ZSWatch/ZSWatch/website/blog/2026-05-31-first-real-prototype/watch-usb-c-connected-debugger-breakout.jpg

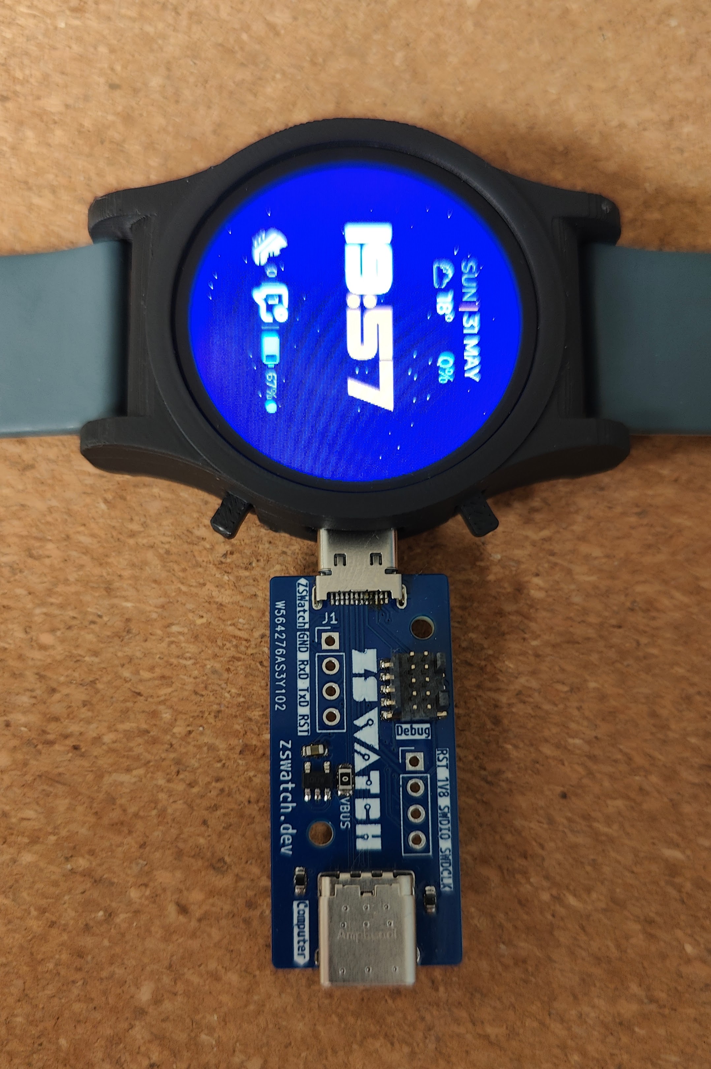
website/blog/2026-05-31-first-real-prototype/watch-usb-c-connected-debugger-breakout.jpg
