ZSWatch/ZSWatch/website/blog/2026-05-31-first-real-prototype/assembled-first-protototype-watch.jpg

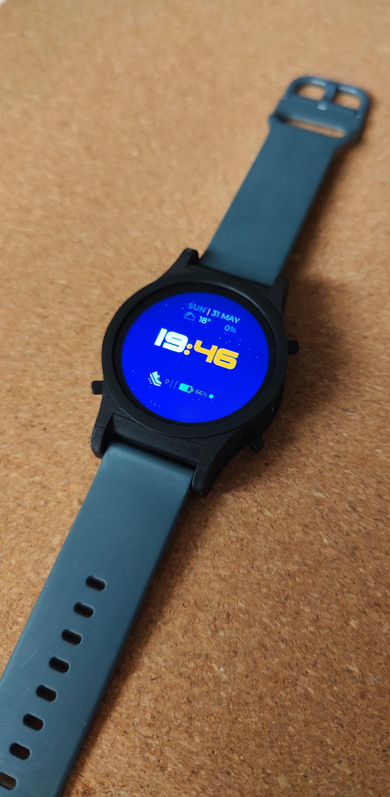
website/blog/2026-05-31-first-real-prototype/assembled-first-protototype-watch.jpg
