ZSWatch/ZSWatch/website/blog/2026-05-31-first-real-prototype/app_pick_local_bg_crop.jpg

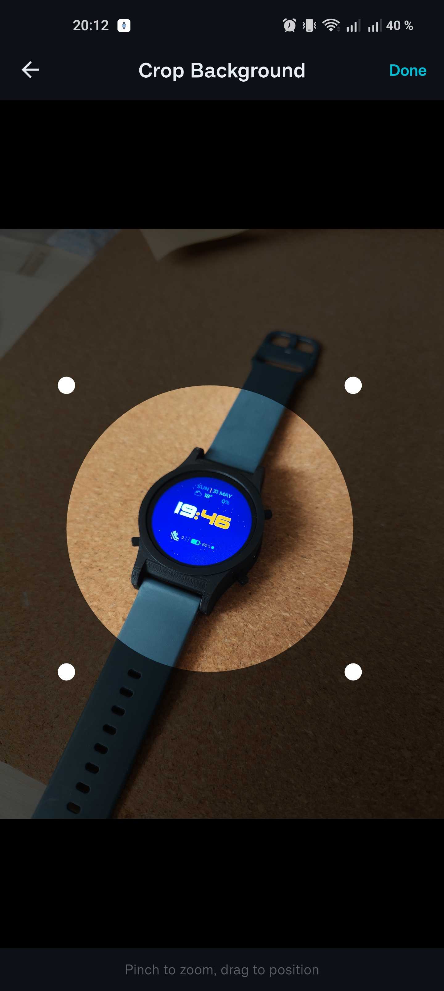
website/blog/2026-05-31-first-real-prototype/app_pick_local_bg_crop.jpg
