ZSWatch/ZSWatch/website/blog/2026-05-31-first-real-prototype/app_pre_made_watch_bgs.jpg

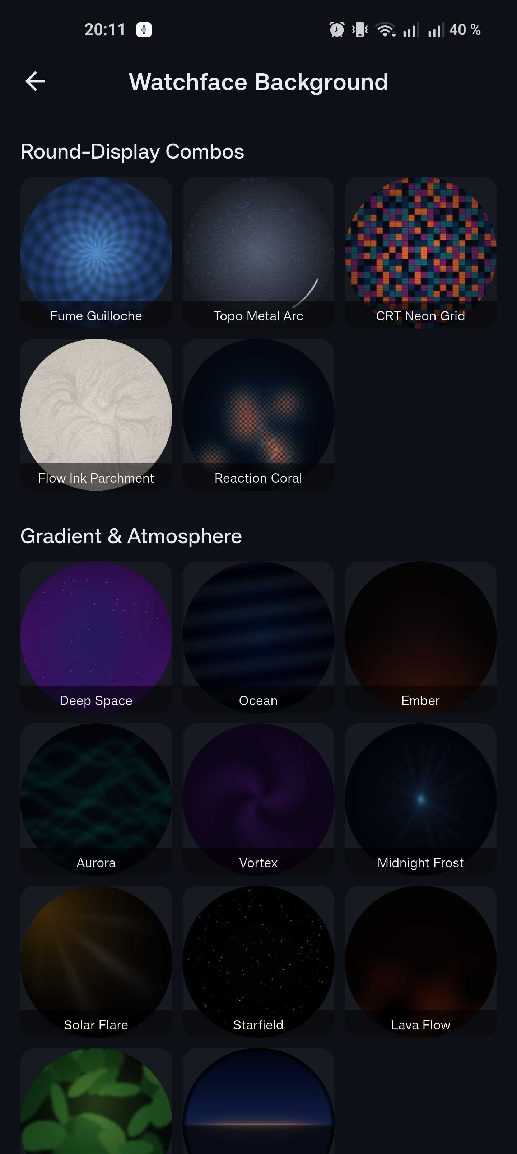
website/blog/2026-05-31-first-real-prototype/app_pre_made_watch_bgs.jpg
