ZSWatch/ZSWatch/website/blog/2026-05-31-first-real-prototype/bare-pcb-watch-and-hr-extention.jpg

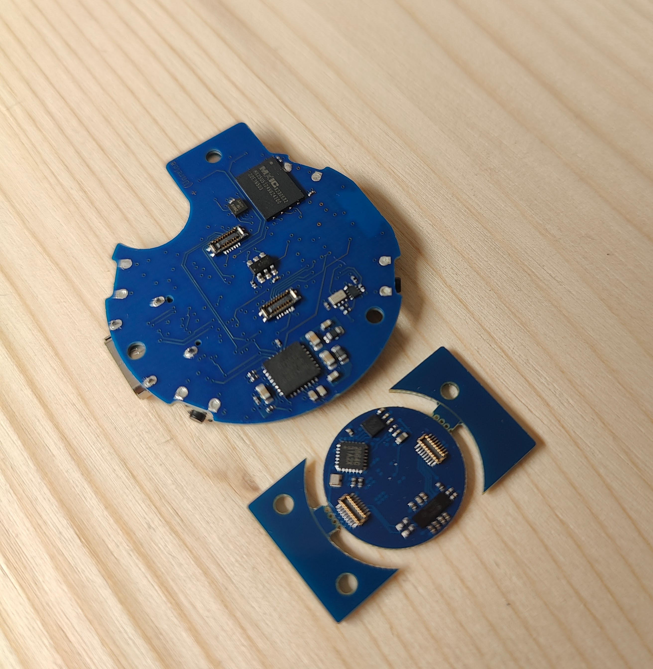
website/blog/2026-05-31-first-real-prototype/bare-pcb-watch-and-hr-extention.jpg
