ZSWatch/ZSWatch/website/blog/2026-05-31-first-real-prototype/bare-pcb-with-hr-mounted-bottom-view.jpg

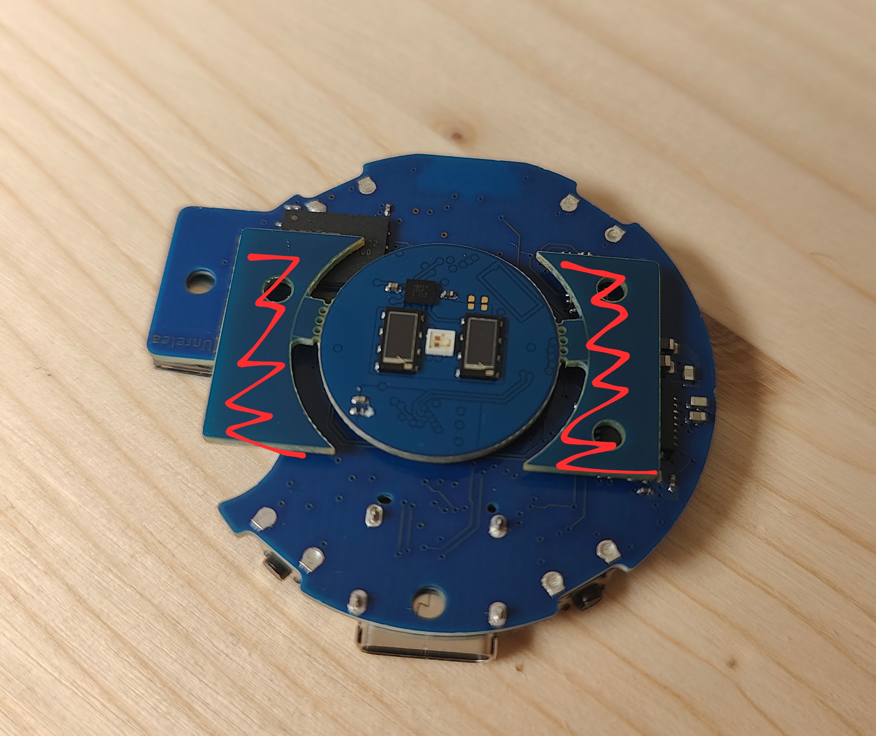
website/blog/2026-05-31-first-real-prototype/bare-pcb-with-hr-mounted-bottom-view.jpg
