ZSWatch/ZSWatch/website/blog/2026-10-28-zswatch-1-0/chat_answer.png

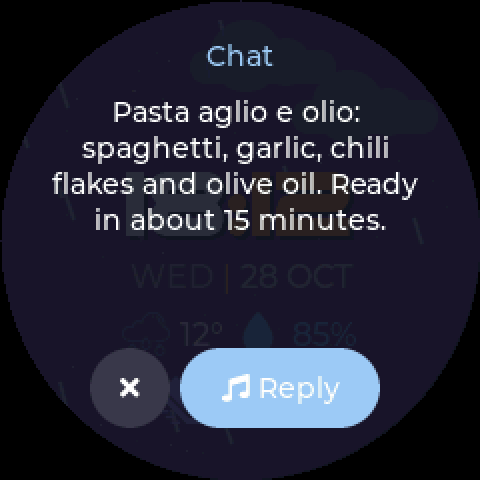
website/blog/2026-10-28-zswatch-1-0/chat_answer.png
