ZSWatch/ZSWatch/app/src/drivers/zsw_vibration_motor.h

/*
 * This file is part of ZSWatch project <https://github.com/zswatch/>.
 * Copyright (c) 2025 ZSWatch Project.
 *
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
 * You should have received a copy of the GNU General Public License
 * along with this program. If not, see <http://www.gnu.org/licenses/>.
 */

#pragma once

#include <stdbool.h>

typedef enum zsw_vibration_pattern {
    ZSW_VIBRATION_PATTERN_CLICK,
    ZSW_VIBRATION_PATTERN_NOTIFICATION,
    ZSW_VIBRATION_PATTERN_ALARM,
    ZSW_VIBRATION_PATTERN_QUICK_REC_START,   /* Short-Long: recording started */
    ZSW_VIBRATION_PATTERN_QUICK_REC_STOP,    /* Short-Short: recording stopped */
    ZSW_VIBRATION_PATTERN_QUICK_REC_ERROR,   /* Long-Long: recording error */
    ZSW_VIBRATION_PATTERN_FIND,              /* Triple buzz: find device */
} zsw_vibration_pattern_t;

/*
* @brief Run a vibration pattern
*
* @details Run a vibration pattern, the pattern will run asynchronously and
* any try to run a pattern while another is running will result in -EBUSY.
*
* @param pattern The pattern to run
* @return 0 on success, negative error code on failure
*/
int zsw_vibration_run_pattern(zsw_vibration_pattern_t pattern);

/*
 * @brief Run a vibration pattern in loop
 *
 * @details Run a vibration pattern in a loop until @ref zsw_vibration_stop is called,
 * the pattern will run asynchronously and any try to run a pattern while another
 * is running will result in -EBUSY.
 *
 * @param pattern The pattern to run
 * @return 0 on success, negative error code on failure
 */
int zsw_vibration_run_pattern_loop(zsw_vibration_pattern_t pattern);

/*
 * @brief Stop any ongoing vibration pattern
 *
 * @details This can be used to stop an ongoing pattern, for example when
 * a timer alarm is dismissed.
*/
void zsw_vibration_stop(void);

/*
* @brief Enable or disable the vibration motor
*
* @details Used to globally disable the vibration motor, for example when the watch
* is in DND mode or when battery is low.
*
* @param enable true to enable, false to disable
*/
int zsw_vibration_set_enabled(bool enable);

/* Stop only a currently running Find pattern; leave alarms/notifications alone. */
bool zsw_vibration_stop_find(void);
