ZSWatch/ZSWatch/app/src/zsw_clock.c

/*
 * This file is part of ZSWatch project <https://github.com/zswatch/>.
 * Copyright (c) 2025 ZSWatch Project.
 *
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
 * You should have received a copy of the GNU General Public License
 * along with this program. If not, see <http://www.gnu.org/licenses/>.
 */

#include <zephyr/init.h>
#include <zephyr/kernel.h>
#include <zephyr/zbus/zbus.h>
#include <zephyr/logging/log.h>
#include <sys/time.h>

#include <stdio.h>
#include <stdlib.h>
#include <errno.h>
#include <unistd.h>

#include "zsw_clock.h"
#include "events/zsw_periodic_event.h"
#include "zsw_retained_ram_storage.h"

#if CONFIG_RTC
#include <zephyr/drivers/rtc.h>
#endif

#if CONFIG_RTC
static const struct device *const rtc = DEVICE_DT_GET(DT_ALIAS(rtc));
// Needed to get rid of strptime warning
char *strptime(const char *buf, const char *format, struct tm *tm);
static bool rtc_is_available;
#endif

static void zbus_periodic_slow_callback(const struct zbus_channel *chan);

ZBUS_CHAN_DECLARE(periodic_event_1s_chan);
ZBUS_LISTENER_DEFINE(zsw_clock_lis, zbus_periodic_slow_callback);

LOG_MODULE_REGISTER(zsw_clock, LOG_LEVEL_INF);

static time_t zsw_clock_get_time_unix(void)
{
    struct timeval tv;

    gettimeofday(&tv, NULL);

    return tv.tv_sec;
}

static void zbus_periodic_slow_callback(const struct zbus_channel *chan)
{
    retained.current_time_seconds = zsw_clock_get_time_unix();
    zsw_retained_ram_update();
}

#if CONFIG_RTC
bool zsw_clock_rtc_available(void)
{
    return rtc_is_available;
}
#endif

void zsw_clock_set_time(zsw_timeval_t *ztm)
{
#if CONFIG_RTC
    if (rtc_is_available) {
        rtc_set_time(rtc, &ztm->tm);
        return;
    }
#endif
    struct timespec tspec;

    tspec.tv_nsec = 0;
    tspec.tv_sec = mktime(&ztm->tm);

    clock_settime(CLOCK_REALTIME, &tspec);
}

void zsw_clock_get_time(zsw_timeval_t *ztm)
{
#if CONFIG_RTC
    if (rtc_is_available) {
        struct rtc_time tm;

        memset(&tm, 0, sizeof(struct rtc_time));
        if (rtc_get_time(rtc, &tm) == 0) {
            memcpy(ztm, &tm, sizeof(struct rtc_time));
        } else {
            LOG_WRN("RTC read failed, falling back to software clock");
            goto sw_fallback;
        }
    } else {
sw_fallback:
        struct tm *tm;
        struct timeval tv;

        gettimeofday(&tv, NULL);
        tm = localtime(&tv.tv_sec);
        memcpy(&ztm->tm, tm, sizeof(struct tm));
    }
#else
    struct tm *tm;
    struct timeval tv;

    gettimeofday(&tv, NULL);
    tm = localtime(&tv.tv_sec);
    memcpy(ztm, tm, sizeof(struct tm));
#endif

    // Add 1900 to the year because we want to count from 1900
    ztm->tm.tm_year += 1900;
}

void zsw_clock_set_timezone(char *tz)
{
    if (strlen(tz) > 0) {
        setenv("TZ", tz, 1);
        tzset();
    }
}

void zsw_timeval_to_tm(zsw_timeval_t *ztm, struct tm *tm)
{
    tm->tm_sec = ztm->tm.tm_sec;
    tm->tm_min = ztm->tm.tm_min;
    tm->tm_hour = ztm->tm.tm_hour;
    tm->tm_mday = ztm->tm.tm_mday;
    tm->tm_mon = ztm->tm.tm_mon;
    tm->tm_year = ztm->tm.tm_year - 1900;
    tm->tm_wday = ztm->tm.tm_wday;
    tm->tm_yday = ztm->tm.tm_yday;
    tm->tm_isdst = ztm->tm.tm_isdst;
}

static int zsw_clock_init(void)
{
    // The RTC stores local calendar fields; mktime needs the retained timezone
    // even when the hardware clock is already running successfully.
    zsw_clock_set_timezone(retained.timezone);
#if CONFIG_RTC
    if (!device_is_ready(rtc)) {
        LOG_WRN("RTC device not ready, falling back to software clock");
        rtc_is_available = false;
        goto fallback;
    }
    struct rtc_time tm;

    memset(&tm, 0, sizeof(struct rtc_time));
    int ret = rtc_get_time(rtc, &tm);
    if (ret == -ENODATA) {
        // RTC has no time set, try to program it with build time
        struct tm build_tm = {0};
        char build_time_str[32];
        snprintf(build_time_str, sizeof(build_time_str), "%s %s", __DATE__, __TIME__);
        strptime(build_time_str, "%b %d %Y %H:%M:%S", &build_tm);

        tm.tm_sec  = build_tm.tm_sec;
        tm.tm_min  = build_tm.tm_min;
        tm.tm_hour = build_tm.tm_hour;
        tm.tm_mday = build_tm.tm_mday;
        tm.tm_mon  = build_tm.tm_mon;
        tm.tm_year = build_tm.tm_year;
        tm.tm_wday = build_tm.tm_wday;
        tm.tm_yday = build_tm.tm_yday;
        tm.tm_isdst = build_tm.tm_isdst;

#ifdef CONFIG_ARCH_POSIX
        struct tm *tp;
        time_t t;
        t = time(NULL);
        tp = localtime(&t);
        t = mktime(tp);
        ret = rtc_set_time(rtc, (struct rtc_time *)tp);
#else
        ret = rtc_set_time(rtc, &tm);
#endif
        if (ret != 0) {
            LOG_WRN("RTC set time failed (err %d), falling back to software clock", ret);
            rtc_is_available = false;
            goto fallback;
        }

        // Verify the RTC accepted the time by reading it back.
        // If the RTC is not properly powered (e.g. no battery),
        // the oscillator cannot start and rtc_get_time will return -ENODATA again
        // Give the oscillator a moment to start before checking.
        k_msleep(100);
        memset(&tm, 0, sizeof(struct rtc_time));
        ret = rtc_get_time(rtc, &tm);
        if (ret != 0) {
            LOG_WRN("RTC not responding after set (err %d), falling back to software clock", ret);
            rtc_is_available = false;
            goto fallback;
        }
    } else if (ret != 0) {
        LOG_WRN("RTC read failed (err %d), falling back to software clock", ret);
        rtc_is_available = false;
        goto fallback;
    }

    rtc_is_available = true;
    LOG_INF("RTC is available and working");
    return 0;

fallback:
#endif
    {
        struct timespec tspec;

        tspec.tv_sec = retained.current_time_seconds;
        tspec.tv_nsec = 0;

        clock_settime(CLOCK_REALTIME, &tspec);
        zsw_clock_set_timezone(retained.timezone);

        zsw_periodic_chan_add_obs(&periodic_event_1s_chan, &zsw_clock_lis);
        LOG_WRN("Using internal software clock (no RTC). Time is restored from retained RAM but will not advance while powered off.");
    }

    return 0;
}

SYS_INIT(zsw_clock_init, APPLICATION, 2);
