ZSWatch/ZSWatch/app/src/managers/zsw_xip_manager.c

/*
 * This file is part of ZSWatch project <https://github.com/zswatch/>.
 * Copyright (c) 2025 ZSWatch Project.
 *
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
 * You should have received a copy of the GNU General Public License
 * along with this program. If not, see <http://www.gnu.org/licenses/>.
 */

#include <zephyr/kernel.h>
#include <zephyr/device.h>
#include <zephyr/drivers/flash/nrf_qspi_nor.h>
#include <zephyr/init.h>
#include <zephyr/logging/log.h>
#include "managers/zsw_xip_manager.h"

static const struct device *qspi_dev = DEVICE_DT_GET_OR_NULL(DT_CHOSEN(nordic_pm_ext_flash));

// Mirrors the driver's XIP user count, which it does not expose.
static uint32_t xip_users;
static K_MUTEX_DEFINE(xip_mutex);

LOG_MODULE_REGISTER(zsw_xip_manager, CONFIG_ZSW_XIP_MANAGER_LOG_LEVEL);

static int zsw_xip_manager_init(void)
{
    if (!qspi_dev) {
        LOG_WRN("No nordic_pm_ext_flash chosen");
        return 0;
    }

    if (!device_is_ready(qspi_dev)) {
        LOG_ERR("QSPI device not ready");
        return -ENODEV;
    }

    /*
     * The QSPI driver enables XIP during init and keeps one internal user
     * reference. Drop that startup reference here so every later enable/disable
     * in application code maps 1:1 to the driver's own refcount.
     */
    nrf_qspi_nor_xip_enable(qspi_dev, false);
    LOG_INF("Released startup XIP reference from QSPI init");

    return 0;
}

SYS_INIT(zsw_xip_manager_init, APPLICATION, 90);

int _zsw_xip_enable(const char *requester)
{
    LOG_WRN("XIP enable request from: %s", requester);

    if (!qspi_dev) {
        LOG_WRN("XIP enable request ignored: no nordic_pm_ext_flash chosen");
        return -ENODEV;
    }

    if (!device_is_ready(qspi_dev)) {
        LOG_ERR("QSPI device not ready");
        return -ENODEV;
    }

    k_mutex_lock(&xip_mutex, K_FOREVER);
    xip_users++;
    nrf_qspi_nor_xip_enable(qspi_dev, true);
    k_mutex_unlock(&xip_mutex);
    return 0;
}

int _zsw_xip_disable(const char *requester)
{
    LOG_WRN("XIP disable request from: %s", requester);

    if (!qspi_dev) {
        return 0;
    }

    if (!device_is_ready(qspi_dev)) {
        LOG_ERR("QSPI device not ready");
        return -ENODEV;
    }

    k_mutex_lock(&xip_mutex, K_FOREVER);
    if (xip_users == 0) {
        LOG_ERR("Unbalanced XIP disable from: %s", requester);
    } else {
        xip_users--;
        nrf_qspi_nor_xip_enable(qspi_dev, false);
    }
    k_mutex_unlock(&xip_mutex);
    return 0;
}

bool zsw_xip_try_get(void)
{
    bool enabled = false;

    if (!qspi_dev || !device_is_ready(qspi_dev)) {
        return false;
    }

    k_mutex_lock(&xip_mutex, K_FOREVER);
    if (xip_users > 0) {
        xip_users++;
        nrf_qspi_nor_xip_enable(qspi_dev, true);
        enabled = true;
    }
    k_mutex_unlock(&xip_mutex);

    return enabled;
}

void zsw_xip_put(void)
{
    k_mutex_lock(&xip_mutex, K_FOREVER);
    if (xip_users == 0) {
        LOG_ERR("Unbalanced XIP put");
    } else {
        xip_users--;
        nrf_qspi_nor_xip_enable(qspi_dev, false);
    }
    k_mutex_unlock(&xip_mutex);
}
