ZSWatch/ZSWatch/app/src/zsw_cpu_freq.c

/*
 * This file is part of ZSWatch project <https://github.com/zswatch/>.
 * Copyright (c) 2025 ZSWatch Project.
 *
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
 * You should have received a copy of the GNU General Public License
 * along with this program. If not, see <http://www.gnu.org/licenses/>.
 */

#include <zsw_cpu_freq.h>
#include <zephyr/kernel.h>
#ifndef CONFIG_ARCH_POSIX
#include <nrfx_clock.h>

//#define CPU_CLOCK_PROFILING

static K_MUTEX_DEFINE(freq_mutex);
static int fast_requests;

static void apply_freq(bool fast)
{
#ifdef CLOCK_FEATURE_HFCLK_DIVIDE_PRESENT
    int ret;
#ifdef CPU_CLOCK_PROFILING
    uint32_t start_time;
    uint32_t stop_time;
    uint32_t cycles_spent;
    uint32_t nanoseconds_spent;
    start_time = k_cycle_get_32();
#endif

    // This configures the clock for CPU APP Core
    ret = nrfx_clock_divider_set(NRF_CLOCK_DOMAIN_HFCLK,
                                 fast ? NRF_CLOCK_HFCLK_DIV_1 : NRF_CLOCK_HFCLK_DIV_2);

    ret -= NRFX_ERROR_BASE_NUM;
    if (ret) {
        return;
    }

    // Wait for the clock to start/stop
    if (fast) {
        nrfx_clock_start(NRF_CLOCK_DOMAIN_HFCLK);
        while (!nrfx_clock_is_running(NRF_CLOCK_DOMAIN_HFCLK, NULL)) {
        }
    } else {
        nrfx_clock_stop(NRF_CLOCK_DOMAIN_HFCLK);
        while (nrfx_clock_is_running(NRF_CLOCK_DOMAIN_HFCLK, NULL)) {
        }
    }
#ifdef CPU_CLOCK_PROFILING
    stop_time = k_cycle_get_32();
    cycles_spent = stop_time - start_time;
    nanoseconds_spent = k_cyc_to_ns_ceil32(cycles_spent);
    if (fast) {
        printk("Start HFCLK took: %dns\n", nanoseconds_spent);
    } else {
        printk("Stop HFCLK took: %dns\n", nanoseconds_spent);
    }
#endif
#endif
}

void zsw_cpu_request_fast(void)
{
    k_mutex_lock(&freq_mutex, K_FOREVER);
    if (fast_requests++ == 0) {
        apply_freq(true);
    }
    k_mutex_unlock(&freq_mutex);
}

void zsw_cpu_release_fast(void)
{
    k_mutex_lock(&freq_mutex, K_FOREVER);
    __ASSERT(fast_requests > 0, "Unbalanced zsw_cpu_release_fast");
    if (fast_requests > 0 && --fast_requests == 0) {
        apply_freq(false);
    }
    k_mutex_unlock(&freq_mutex);
}

bool zsw_cpu_is_fast(void)
{
#ifdef CLOCK_FEATURE_HFCLK_DIVIDE_PRESENT
    return nrf_clock_hfclk_div_get(NRF_CLOCK) == NRF_CLOCK_HFCLK_DIV_1;
#else
    return false;
#endif
}
#else
void zsw_cpu_request_fast(void) {}

void zsw_cpu_release_fast(void) {}

bool zsw_cpu_is_fast(void)
{
    return false;
}
#endif
