ZSWatch/ZSWatch/app/src/ui/zsw_ui_controller.c

/*
 * This file is part of ZSWatch project <https://github.com/zswatch/>.
 * Copyright (c) 2025 ZSWatch Project.
 *
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
 * You should have received a copy of the GNU General Public License
 * along with this program. If not, see <http://www.gnu.org/licenses/>.
 */

#include <zephyr/input/input.h>
#include <zephyr/dt-bindings/input/cst816s-gesture-codes.h>
#include <zephyr/kernel.h>
#include <zephyr/logging/log.h>
#include <zephyr/pm/device.h>
#include <zephyr/settings/settings.h>
#include <zephyr/sys/reboot.h>

#include <stdint.h>
#include <string.h>

#include <lvgl.h>

#include "filesystem/zsw_filesystem.h"
#include "zsw_retained_ram_storage.h"
#include "applications/watchface/watchface_app.h"
#include "drivers/zsw_display_control.h"
#include "drivers/zsw_vibration_motor.h"
#include "fuel_gauge/zsw_pmic.h"
#include "zsw_app_manager.h"
#include "zsw_notification_manager.h"
#include "zsw_power_manager.h"
#include "zsw_ui_controller.h"
#include "ui/zsw_ui.h"
#include "ui/onboarding/zsw_onboarding_ui.h"
#include "lvgl_editor_gen.h"

#ifdef CONFIG_APPLICATIONS_USE_VOICE_MEMO
#include "managers/zsw_recording_manager.h"
#include "ui/overlay/zsw_recording_overlay.h"
#include "ui/overlay/zsw_voice_memo_popup.h"
#endif

typedef enum ui_state {
    INIT_STATE,
    WATCHFACE_STATE,
    APPLICATION_MANAGER_STATE,
} ui_state_t;

static void run_input_work(struct k_work *item);

static struct input_worker_item_t {
    struct k_work work;
    struct input_event event;
} input_worker_item = {
    .work = Z_WORK_INITIALIZER(run_input_work),
};

static struct input_event last_input_event;

static bool is_buttons_for_lvgl = false;

static lv_obj_t *root_screen;
static lv_group_t *input_group;
static lv_group_t *temp_group;
static lv_indev_t *enc_indev;
static lv_indev_t *touch_indev;
static uint8_t last_pressed;
static ui_state_t watch_state = INIT_STATE;
static bool swipe_back_enabled;

static void encoder_read(lv_indev_t *indev, lv_indev_data_t *data);
static void on_input_subsys_callback(struct input_event *evt, void *user_data);
static void on_watchface_app_event_callback(watchface_app_evt_t evt);
static void on_root_screen_gesture(lv_event_t *e);
static void async_turn_off_buttons_allocation(void *unused);
static void open_application_manager_page(void *app_name);
static void on_application_manager_close(void);
static void on_onboarding_done(void);
static bool handle_back_action(void);
static int settings_load_handler_swipe_back(const char *key, size_t len,
                                            settings_read_cb read_cb,
                                            void *cb_arg, void *param);

LOG_MODULE_REGISTER(zsw_ui_controller, CONFIG_ZSW_UI_CONTROLLER_LOG_LEVEL);

static bool handle_back_action(void)
{
#ifdef CONFIG_APPLICATIONS_USE_VOICE_MEMO
    if (zsw_recording_overlay_is_shown()) {
        zsw_recording_manager_stop();
        zsw_recording_overlay_hide();
        return true;
    }

    if (zsw_voice_memo_popup_is_shown()) {
        return true;
    }
#endif

    if (zsw_notification_popup_is_shown()) {
        zsw_notification_popup_remove();
        return true;
    }

    if (watch_state == APPLICATION_MANAGER_STATE) {
        zsw_app_manager_exit_app();
        return true;
    }

    return false;
}

static void run_input_work(struct k_work *item)
{
    struct input_worker_item_t *container = CONTAINER_OF(item, struct input_worker_item_t, work);

    LOG_DBG("Input worker code: %u", container->event.code);

    // Don't process the press if it caused wakeup.
    if (zsw_power_manager_reset_idle_timout()) {
        return;
    }

    if (container->event.type == INPUT_EV_KEY) {
        switch (container->event.code) {
            case (INPUT_KEY_Y): {
#if(CONFIG_MISC_ENABLE_SYSTEM_RESET && !CONFIG_DT_HAS_NORDIC_NPM1300_ENABLED)
                LOG_INF("Force restart");

                retained.off_count += 1;
                zsw_retained_ram_update();
                sys_reboot(SYS_REBOOT_COLD);
#endif
                break;
            }
            case INPUT_KEY_3: {
                if (handle_back_action()) {
                    return;
                }

                break;
            }
            case INPUT_KEY_1: {
                if ((watch_state == WATCHFACE_STATE) && !zsw_notification_popup_is_shown()
#ifdef CONFIG_APPLICATIONS_USE_VOICE_MEMO
                    && !zsw_recording_overlay_is_shown()
                    && !zsw_voice_memo_popup_is_shown()
#endif
                   ) {
                    zsw_vibration_run_pattern(ZSW_VIBRATION_PATTERN_CLICK);
                    lv_async_call(open_application_manager_page, NULL);
                }

                break;
            }
        }
    }

    // Handled by LVGL
    if (container->event.type == INPUT_EV_KEY) {
        if (is_buttons_for_lvgl) {
            memcpy(&last_input_event, &container->event, sizeof(struct input_event));
            return;
        }
    }
}

static void open_application_manager_page(void *app_name)
{
    if (watch_state != WATCHFACE_STATE) {
        return;
    }
    watchface_app_stop();
    is_buttons_for_lvgl = true;
    watch_state = APPLICATION_MANAGER_STATE;
    zsw_app_manager_show(on_application_manager_close, root_screen, input_group, (char *)app_name);
}

void zsw_ui_controller_set_swipe_back_enabled(bool enabled)
{
    swipe_back_enabled = enabled;
}

void zsw_ui_controller_set_notification_mode(void)
{
    lv_group_set_default(temp_group);
    lv_indev_set_group(enc_indev, temp_group);
    is_buttons_for_lvgl = true;
}

void zsw_ui_controller_clear_notification_mode(void)
{
    lv_group_set_default(input_group);
    lv_indev_set_group(enc_indev, input_group);
    if (watch_state == WATCHFACE_STATE) {
        is_buttons_for_lvgl = false;
    } else {
        is_buttons_for_lvgl = true;
    }
}

static void on_application_manager_close(void)
{
    zsw_app_manager_delete();
    watch_state = WATCHFACE_STATE;
    watchface_app_start(root_screen, input_group, on_watchface_app_event_callback);
    lv_async_call(async_turn_off_buttons_allocation, NULL);
}

static void async_turn_off_buttons_allocation(void *unused)
{
    is_buttons_for_lvgl = false;
}

static void on_root_screen_gesture(lv_event_t *e)
{
    lv_indev_t *indev = lv_indev_active();

    if (lv_event_get_code(e) != LV_EVENT_GESTURE || indev == NULL) {
        return;
    }

    lv_dir_t dir = lv_indev_get_gesture_dir(indev);

    if (!swipe_back_enabled) {
        return;
    }

    if (dir != LV_DIR_TOP) {
        return;
    }

    if (handle_back_action()) {
        lv_indev_wait_release(indev);
    }
}

static void on_input_subsys_callback(struct input_event *evt, void *user_data)
{
    zsw_power_manager_on_user_activity();

    LOG_DBG("Input event received: type=%u, code=%u, value=%d", evt->type, evt->code, evt->value);

    // The following events are ignored (will block a wakeup of the display):
    //  - Generic touch events (INPUT_BTN_TOUCH, INPUT_ABS_X, INPUT_ABS_Y)
    //  - Raw button codes before longpress processing (INPUT_KEY_KP0, INPUT_KEY_KP1)
    //  - Quick-record long-press code (INPUT_KEY_F1) — handled by zsw_quick_record
    if ((evt->code == INPUT_ABS_X) || (evt->code == INPUT_ABS_Y) || (evt->code == INPUT_BTN_TOUCH) ||
        (evt->code == INPUT_KEY_KP0) || (evt->code == INPUT_KEY_KP1) ||
#ifdef CONFIG_APPLICATIONS_USE_VOICE_MEMO
        (evt->code == INPUT_KEY_F1) ||
#endif
        ((evt->code != INPUT_EV_DEVICE) && (evt->value == 1))) {
        return;
    }

    input_worker_item.event = *evt;
    k_work_submit(&input_worker_item.work);
}

static void handle_screen_gesture(lv_dir_t event_code)
{
    bool overlay_active = zsw_notification_popup_is_shown();
#ifdef CONFIG_APPLICATIONS_USE_VOICE_MEMO
    overlay_active = overlay_active || zsw_recording_overlay_is_shown() || zsw_voice_memo_popup_is_shown();
#endif
    if (watch_state == WATCHFACE_STATE && !overlay_active) {
        switch (event_code) {
            case LV_DIR_LEFT: {
                open_application_manager_page("Notification");
                break;
            }
            case LV_DIR_RIGHT: {
                open_application_manager_page("Face");
                break;
            }
            case LV_DIR_TOP: {
                open_application_manager_page(NULL);
                break;
            }
            case LV_DIR_BOTTOM: {
                break;
            }
            default:
                __ASSERT(false, "Not a valid gesture code: %d", event_code);
        }
        lv_indev_t *indev = lv_indev_get_act();
        if (indev) {
            lv_indev_wait_release(indev);
        }
    } else if (overlay_active) {
        if (zsw_notification_popup_is_shown()) {
            zsw_notification_popup_remove();
        }
    }
}

static void encoder_read(lv_indev_t *indev, lv_indev_data_t *data)
{
    if (!is_buttons_for_lvgl) {
        return;
    }

    if (last_input_event.code == INPUT_KEY_4) {
        data->key = LV_KEY_LEFT;
        data->state = LV_INDEV_STATE_PR;
        last_pressed = 2;
    } else if (last_input_event.code == INPUT_KEY_1) {
        data->key = LV_KEY_ENTER;
        data->state = LV_INDEV_STATE_PR;
        last_pressed = 1;
    } else if (last_input_event.code == INPUT_KEY_2) {
        data->key = LV_KEY_RIGHT;
        data->state = LV_INDEV_STATE_PR;
        last_pressed = 3;
    } else if (last_input_event.code == INPUT_KEY_3) {
        // Not used for now. TODO exit/back button.
    } else {
        if (last_pressed == 0xFF) {
            return;
        }
        data->state = LV_INDEV_STATE_REL;
        switch (last_pressed) {
            case 2:
                data->key = LV_KEY_RIGHT;
                break;
            case 1:
                data->key = LV_KEY_ENTER;
                break;
            case 3:
                data->key = LV_KEY_LEFT;
                break;
            default:
                break;
        }
        last_pressed = 0xFF;
    }

    last_input_event.code = 0xFF;
}

static void handle_watchface_open_app_event(watchface_app_evt_open_app_t click)
{
    switch (click) {
        case WATCHFACE_APP_EVT_CLICK_BATT:
            open_application_manager_page("Battery");
            break;
        case WATCHFACE_APP_EVT_CLICK_STEP:
            open_application_manager_page("Fitness");
            break;
        case WATCHFACE_APP_EVT_CLICK_WEATHER:
            break;
        case WATCHFACE_APP_EVT_CLICK_MUSIC:
            open_application_manager_page("Music");
            break;
        case WATCHFACE_APP_EVT_CLICK_SETTINGS:
            open_application_manager_page("Settings");
            break;
        case WATCHFACE_APP_EVT_CLICK_FLASHLIGHT:
            open_application_manager_page("Flashlight");
            break;
        default:
            break;
    }
}

static void on_watchface_app_event_callback(watchface_app_evt_t evt)
{
    if (watch_state != WATCHFACE_STATE) {
        return;
    }
    if (evt.type == WATCHFACE_APP_EVENT_GESTURE) {
        handle_screen_gesture(evt.data.gesture_direction);
        return;
    }

    if (watch_state == WATCHFACE_STATE && !zsw_notification_popup_is_shown()
#ifdef CONFIG_APPLICATIONS_USE_VOICE_MEMO
        && !zsw_recording_overlay_is_shown()
        && !zsw_voice_memo_popup_is_shown()
#endif
       ) {
        switch (evt.type) {
            case WATCHFACE_APP_EVENT_OPEN_APP:
                handle_watchface_open_app_event(evt.data.app);
                break;
            case WATCHFACE_APP_EVENT_SET_BRIGHTNESS:
                zsw_display_control_set_brightness(evt.data.brightness);
                zsw_settings_brightness_t brightness = evt.data.brightness;
                if (evt.data.store_brightness) {
                    settings_save_one(ZSW_SETTINGS_BRIGHTNESS, &brightness, sizeof(brightness));
                }
                break;
            case WATCHFACE_APP_EVENT_RESTART:
                sys_reboot(SYS_REBOOT_COLD);
                break;
            case WATCHFACE_APP_EVENT_SHUTDOWN:
#if CONFIG_DT_HAS_NORDIC_NPM1300_ENABLED
                int ret = zsw_pmic_power_down();
                if (ret == -ENOTSUP) {
                    // If the nPM1300 is charging thenpowering down/entering ship mode is not possible
                    // Instead we just do a reset
                    ret = zsw_pmic_reset();
                    if (ret) {
                        LOG_ERR("Failed to power down or reset the PMIC");
                    }
                }
#endif
                break;
            default:
                break;
        }
    }
}

static void on_onboarding_done(void)
{
    zsw_settings_onboarding_done_t done = true;
    settings_save_one(ZSW_SETTINGS_ONBOARDING_DONE, &done, sizeof(done));
    zsw_onboarding_ui_remove();
    watch_state = WATCHFACE_STATE;
    watchface_app_start(root_screen, input_group, on_watchface_app_event_callback);
}

static int settings_load_handler_onboarding(const char *key, size_t len,
                                            settings_read_cb read_cb,
                                            void *cb_arg, void *param)
{
    if (len != sizeof(zsw_settings_onboarding_done_t)) {
        return -EINVAL;
    }

    int rc = read_cb(cb_arg, param, sizeof(zsw_settings_onboarding_done_t));
    if (rc < 0) {
        return rc;
    }

    return 0;
}

static int settings_load_handler_swipe_back(const char *key, size_t len,
                                            settings_read_cb read_cb,
                                            void *cb_arg, void *param)
{
    if (len != sizeof(zsw_settings_swipe_back_t)) {
        return -EINVAL;
    }

    int rc = read_cb(cb_arg, param, sizeof(zsw_settings_swipe_back_t));
    if (rc < 0) {
        return rc;
    }

    return 0;
}

int zsw_ui_controller_init(void)
{
    // Initialize LVGL Editor subjects and assets
    lvgl_editor_init_gen("");

    root_screen = lv_scr_act();
    lv_obj_add_event_cb(root_screen, on_root_screen_gesture, LV_EVENT_GESTURE, NULL);

    lv_obj_set_style_bg_color(root_screen, zsw_color_dark_gray(), LV_PART_MAIN | LV_STATE_DEFAULT);

    // Need to enable the gpio-keys as they are suspended by default
    pm_device_action_run(DEVICE_DT_GET(DT_NODELABEL(buttons)), PM_DEVICE_ACTION_RESUME);
    INPUT_CALLBACK_DEFINE(NULL, on_input_subsys_callback, NULL);

    enc_indev = lv_indev_create();
    lv_indev_set_type(enc_indev, LV_INDEV_TYPE_ENCODER);
    lv_indev_set_read_cb(enc_indev, encoder_read);
    lv_indev_set_group(enc_indev, input_group);

    input_group = lv_group_create();
    lv_group_set_default(input_group);
    lv_indev_set_group(enc_indev, input_group);
    temp_group = lv_group_create();

    touch_indev = lv_indev_get_next(NULL);
    while (touch_indev) {
        if (lv_indev_get_type(touch_indev) == LV_INDEV_TYPE_POINTER) {
            // TODO First fix so not all presses everyw
            //here are registered as clicks and cause vibration
            // Clicking anywhere with this below added right now will cause a vibration, which
            // is not what we want
            // touch_indev->driver->feedback_cb = click_feedback;
            break;
        }
        touch_indev = lv_indev_get_next(touch_indev);
    }

    zsw_settings_onboarding_done_t onboarding_done = false;
    swipe_back_enabled = false;
    int err = settings_load_subtree_direct(ZSW_SETTINGS_SWIPE_BACK,
                                           settings_load_handler_swipe_back,
                                           &swipe_back_enabled);
    if (err != 0) {
        LOG_WRN("Failed to load swipe-back setting, defaulting disabled");
    } else {
        LOG_INF("Swipe-back setting loaded: %d", swipe_back_enabled);
    }
#ifdef CONFIG_ZSW_TEST_SKIP_ONBOARDING
    onboarding_done = true;
    LOG_INF("Test mode: skipping onboarding");
#else
    err = settings_load_subtree_direct(ZSW_SETTINGS_ONBOARDING_DONE,
                                       settings_load_handler_onboarding,
                                       &onboarding_done);
    if (err != 0) {
        LOG_WRN("Failed to load onboarding setting, assuming first boot");
    }
#endif

    if (!onboarding_done) {
        watch_state = INIT_STATE;
        zsw_onboarding_ui_show(root_screen, on_onboarding_done);
    } else {
        watch_state = WATCHFACE_STATE;
        watchface_app_start(root_screen, input_group, on_watchface_app_event_callback);

#ifdef CONFIG_ZSW_TEST_AUTO_LAUNCH_APP
        if (strlen(CONFIG_ZSW_TEST_AUTO_LAUNCH_APP) > 0) {
            LOG_INF("Test mode: auto-launching app '%s'", CONFIG_ZSW_TEST_AUTO_LAUNCH_APP);
            lv_async_call(open_application_manager_page, (void *)CONFIG_ZSW_TEST_AUTO_LAUNCH_APP);
        }
#endif
    }

    LOG_INF("UI Controller initialized");

    return 0;
}

void zsw_ui_controller_launch_app(const char *app_name)
{
    static char launch_app_name_buf[64];
    strncpy(launch_app_name_buf, app_name, sizeof(launch_app_name_buf) - 1);
    launch_app_name_buf[sizeof(launch_app_name_buf) - 1] = '\0';
    lv_async_call(open_application_manager_page, launch_app_name_buf);
}

zsw_ui_state_t zsw_ui_controller_get_state(void)
{
    switch (watch_state) {
        case INIT_STATE:
            return ZSW_UI_STATE_INIT;
        case WATCHFACE_STATE:
            return ZSW_UI_STATE_WATCHFACE;
        case APPLICATION_MANAGER_STATE:
            return ZSW_UI_STATE_APP_MANAGER;
        default:
            return ZSW_UI_STATE_INIT;
    }
}

const char *zsw_ui_controller_get_running_app_name(void)
{
    if (watch_state != APPLICATION_MANAGER_STATE) {
        return NULL;
    }
    int num_apps = zsw_app_manager_get_num_apps();
    for (int i = 0; i < num_apps; i++) {
        application_t *app = zsw_app_manager_get_app(i);
        if (app && app->current_state != ZSW_APP_STATE_STOPPED) {
            return app->name;
        }
    }
    return NULL;
}
