ZSWatch/ZSWatch/app/src/ui/zsw_ui_controller.h

/*
 * This file is part of ZSWatch project <https://github.com/zswatch/>.
 * Copyright (c) 2025 ZSWatch Project.
 *
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
 * You should have received a copy of the GNU General Public License
 * along with this program. If not, see <http://www.gnu.org/licenses/>.
 */

#ifndef ZSW_UI_CONTROLLER_H
#define ZSW_UI_CONTROLLER_H

#include <stdbool.h>

/**
 * @brief Initialize the UI controller system
 *
 * Initializes the main UI system including:
 * - Root screen setup
 * - Input handling for buttons and touch events
 * - LVGL encoder input device configuration
 * - Input groups for managing focus
 * - Screen gesture event callbacks
 * - Watchface application startup
 *
 * @return 0 on success, negative error code on failure
 */
int zsw_ui_controller_init();

/**
 * @brief Enable notification mode for UI controller
 *
 * Switches the UI to notification mode by:
 * - Setting the temporary input group as default
 * - Routing encoder input to the temporary group
 * - Enabling LVGL button handling for notifications
 *
 * This allows notification popups to receive and handle input events.
 */
void zsw_ui_controller_set_notification_mode(void);

/**
 * @brief Clear notification mode and restore normal controller operation
 *
 * Restores normal UI navigation by:
 * - Setting the main input group as default
 * - Routing encoder input back to the main group
 * - Disabling LVGL button handling if in watchface state
 * - Keeping LVGL button handling enabled if in application manager state
 *
 * This returns input handling to the appropriate state based on current UI mode.
 */
void zsw_ui_controller_clear_notification_mode(void);

/** @brief Enable or disable swipe-up back navigation at runtime. */
void zsw_ui_controller_set_swipe_back_enabled(bool enabled);

typedef enum {
    ZSW_UI_STATE_INIT = 0,
    ZSW_UI_STATE_WATCHFACE,
    ZSW_UI_STATE_APP_MANAGER,
} zsw_ui_state_t;

/** @brief Launch an app by name from any thread context.
 *
 *
 *  @param app_name Name of the app to launch.
 */
void zsw_ui_controller_launch_app(const char *app_name);

/** @brief Get current UI controller state. */
zsw_ui_state_t zsw_ui_controller_get_state(void);

/** @brief Get the name of the currently running app.
 *  @return App name, or NULL if no app is running.
 */
const char *zsw_ui_controller_get_running_app_name(void);

#endif /* ZSW_UI_CONTROLLER_H */
