ZSWatch/ZSWatch/(commit log)

2026-03-16 feat: voice memo recording manager + popup with rich AI result info
    - Refactor voice recording into zsw_recording_manager (zbus-based)
    - Add zsw_recording_overlay: HUD pill with blinking dot, timer, level bar
    - Add zsw_quick_record: long-press button 4 to start, short-press to stop
    - Add zsw_voice_memo_popup: confirmation popup after AI processing
    - Shows action type (Calendar Event / Task / Reminder) with color-coded icon
    - Displays title in white 16pt font (was gray 14pt)
    - Formats and shows datetime (e.g. 'Mar 15, 14:30') when available
    - Add zsw_voice_memo_event zbus channel for result events
    - Restructure voice_memo_app.c: decouple BLE, use recording manager
    - Parse action_type an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
    [main.c]
2026-03-20 docs: update firmware update instructions for auto SMP enable
    The companion app now enables SMP automatically. Manual steps are
    only needed for the web updater and nRF Device Manager.
2026-03-20 Enable runtime thread info over shell.
2026-03-20 Add Companion app coredump analysis support using a new server.
    - BLE: send commit SHA and debug flag in ver message, add coredump
    info message on connect, add coredump_erase command handler
    - FW: move coredump storage from /lvgl_lfs to /user partition,
    add crash test shell command with multi-frame call stack for
    verifiable GDB backtraces
    - Server: add coredump analysis endpoint with SHA-based ELF cache,
    GDB RSP server integration, and ELF upload endpoint
    - Fix elf_parser.py format string bug (bytes vs len)
    - Pytest: add E2E coredump tests (summary, erase, crash+download)
    - Vendor Zephyr coredump tools (coredump_gdbserver, coredump_serial_log_parser,
    gdbstubs for ARM Cortex-M/ARM64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
2026-03-20 ci: upload ELF to coredump server for all boards after build
    Upload debug and release ELFs for all hardware boards (not native_sim)
    to the coredump analysis server after CI builds. Uses continue-on-error
    so the build never fails due to upload issues.
    Requires COREDUMP_API_KEY and COREDUMP_SERVER_URL repository secrets.
2026-03-20 shell: Add commands for remote button and touch input.
2026-04-06 fix: reschedule idle close timer on mcumgr fs upload offset mismatch recovery
    Without this, BLE packet loss during pipelined SMP uploads could cause
    the 10s idle timer to expire mid-recovery, auto-closing the file and
    failing the transfer.
2026-04-06 boards: increase MCUmgr FS max file size to 4GB
    Background image upload (~115KB) fails with EFAULT (-14) because
    the default CONFIG_MCUMGR_GRP_FS_MAX_FILE_SIZE_64KB limits offsets
    to 3 bytes (max 65535). Switch to 4GB to support files >64KB.
2026-04-28 ble: gadgetbridge: add find device handler
    Parse find device message and trigger vibration motor and
    wake the display until {"t":"find","n":false} is received.
    [zsw_vibration_motor.c, zsw_vibration_motor.h]
2026-05-04 vibration_motor: add continuous pattern option
    add option for running a pattern in a loop until explicitly stopped.
    [zsw_vibration_motor.c, zsw_vibration_motor.h]
2026-05-04 ble: change to use loop pattern for find device
    change find device handler to use zsw_vibration_run_pattern_loop
2026-05-04 timers: run vibration pattern continuously until pop up is dismissed
    Run the vibration pattern until the pop up is dimissed or timeout.
2026-05-04 watchfaces: Extract some common watchface date and battery icon code .
2026-05-04 Fix concurrent XIP and flash writes causing corrupt flash usiing new approach to block LVGL rendering when working with filesystem.
    [zsw_display_control.c, zsw_display_control.h, zsw_smp_manager.c]
2026-05-05 Add setting to navigate the watch without physical buttons. Swipe down => back. (#571)
    Some TODO issues still:
    - Apps that are full screen scrollable list are hard to exit.
    [zsw_settings.h, zsw_ui_controller.c, zsw_ui_controller.h]
2026-05-08 LE Audio Broadcast Assistant
    [astyle.cfg]
2026-05-08 Add LEA Assistant demo flow and UI
2026-05-23 docs: Update documentation for swipe-up back gesture feature
    - Add navigation controls section to Quick Start guide explaining button layout and new swipe gesture
    - Update Writing Apps guide to mention swipe-up gesture as alternative back action trigger
    - Document that back_func can be triggered by button press or swipe gesture (when enabled)
    Related to PR #571
2026-05-23 boards: Increase Display Voltage to 3V3 to fix flickering on max brightness.
    Still within spec. of the disply.
2026-06-02 website: blog: Write "First Real ZSWatch Prototype is Working" blog post.
2026-08-13 ui: change to k_msgq for thread safety, fix some issues.
2026-10-02 fix(pytest): allow capability-filtered empty device sets
2026-10-04 Add fixed opt-in companion HTTP lab probes
2026-10-07 Restart sensor notifications when a bonded peer rewrites enabled CCCD
2026-10-12 tools: retain debugger flash and UART capture helpers for handoff
2026-10-16 fix: resume complete NUS messages after ATT buffer pressure
2026-10-18 HR: Update driver and fix sampling thread wakeup.
    Use the merged MAX32664C changes. Use a semaphore to wake the sampling thread and allow retrying a failed stop.
2026-10-18 Reduce idle current and track IMU motion from boot.
    Turn off the touch level shifter with the display and let unused UART hardware sleep.
    Use 50 Hz accelerometer sampling while stationary. Keep 100 Hz when the gyro is in use. UART logging builds keep the UART enabled to avoid scrolling stutter.
2026-10-18 HR: Add background measurements and saved mode selection.
    Add Off, Background and Continuous modes, plus manual measurements.
    The manager controls the sensor independently of the app and stores accepted readings for the graph. Stop a background attempt when a reading is accepted or after 45 seconds without a result.
2026-10-18 Add shell commands for HR and power testing.
    Add mode selection, manual measurement, cancel and status commands. Also add motion injection, sleep/wake commands and stack usage.
2026-10-18 sensor_fusion: use the Kconfig names for the RTT output
    The code tested CONFIG_SEND_SENSOR_READING_OVER_RTT, which no longer
    exists, so the RTT output could never be compiled. Use the
    SENSOR_FUSION_ prefixed options and default them off to keep the
    current behavior.
2026-10-18 boards: legacy v5: drop the unused USB shell UART
    The shell and MCUmgr shared the CDC ACM UART and MCUmgr owns it, so
    the serial shell backend was unusable. The other boards dropped it
    already.
2026-10-18 ble: batch sensor notifications explicitly instead of auto flushing
    Zephyr's automatic notification batching (BT_GATT_NOTIFY_MULTIPLE_FLUSH_MS)
    appends to one shared buffer per connection without locking. When
    MCUmgr notifies from its workqueue while the system workqueue notifies
    or flushes that buffer, the same buffer can be sent twice and the ATT
    layer later asserts on an empty buffer in chan_send. This reproduced in
    4 of 5 runs during SMP traffic right after a connection interval update.
    Disable the automatic batching and let the sensor server send its
    readings with bt_gatt_notify_multiple(), so they still go out in one
    PDU when the client supports it. Fall back to one notification per
    c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
2026-10-25 Fix switching watchface while a watchface is shown
    watchface_change() removed the face but not the dropdown, so opening the
    new face asserted in zsw_watchface_dropdown_ui_add().
2026-10-25 Add shell commands to inject weather and time and switch watchface
    event weather/time publish on ble_comm_data_chan like a phone update,
    watchface list/set switches faces and lv_timers counts LVGL timers and
    running animations. Used to test watchfaces on native_sim.
2026-10-25 Add Living Sky watchface
    Weather effects (sun, moon and stars, clouds, rain, snow, fog, lightning)
    and a time of day tint drawn on top of the watchface background. Effects
    animate in a short burst when the face is shown, the display turns on, the
    weather changes or the face is tapped, then stop and keep a static frame.
2026-10-27 Add altimeter application and pressure event enhancements
    - Introduced `altimeter_app.h` with a function for starting altimeter calibration.
    - Updated `pressure_event.h` to clarify pressure and temperature units.
    - Implemented `pressure_publish_mode_event` to manage pressure data publishing modes (slow/fast).
    - Created `step_snapshot_mode_event` to handle step snapshot mode enabling/disabling.
    - Enhanced `zsw_imu.c` to support step snapshot mode, including periodic publishing of step counts.
    - Modified `zsw_pressure_sensor.c` to allow dynamic pressure data publishing rates based on mode.
    - Added shell commands for injecting pressure and step events for testing purposes.
2026-10-28 Simulate the heart rate sensor on native_sim
    Add a native_sim backend for the zsw_hr API that reports an on-skin
    heart rate between 64 and 82 bpm. The HR manager, the hr shell
    commands, Tiles and the HR app now get data in the simulator.
2026-10-28 refactor: Refactor altimeter application to implement elevation tracking and remove pressure publish mode events
2026-10-28 Add floor counter functionality with pressure and step fusion
    - Introduced zsw_floor_counter module for tracking floors climbed and descended.
    - Integrated pressure and step data to determine floor changes during activity.
    - Implemented a state machine for managing floor counting episodes and inactivity timeouts.
    - Added shell command to retrieve daily floor counts.
    - Updated existing sensor modules to support new floor counter functionality.
    - Enhanced logging for debugging and tracking purposes.
2026-10-29 watchdk: disable touch level shifter with the display rail
    The NTS0104 output enable on P0.20 was hogged high, same as on the
    ZSWatch before 847d87ef. Control it as a regulator together with the
    display supply, like the ZSWatch board does.
2026-10-29 pytest: wait 240 s before the stationary power measurement
    Stationary needs 160 s without motion, counted from shortly after boot.
    On a Watch DK it started 162 s after power-on, so the 180 s wait left
    18 s of margin and any bump after the power cycle made the test measure
    inactive current instead.
2026-10-29 bmi270: add step counter interrupt diagnostics
    CONFIG_ZSW_BMI270_STEP_DEBUG (boards/step_debug.conf) counts GPIO,
    processed and step interrupts, logs the step counter config and INT
    mapping after every reconfiguration, and logs a 10 s summary in
    zsw_imu that warns about missed step interrupts. In this mode
    SENSOR_TRIG_STEP is only reported when the step interrupt bit is set.
2026-10-29 Read image resources through the XIP mapping
    Each flash_area_read() of the image partition costs about 85 us of QSPI
    driver overhead, and the single 4 KB read-ahead cache thrashes when LVGL
    reads rows from several images, so a full watchface redraw spent 206 of
    256 ms reading images.
    While XIP is already on (the display is on), read images with memcpy from
    the memory mapped flash instead. Image files take an XIP reference at open
    and drop it at close, so XIP can not be turned off mid read. With XIP off
    the old flash_area_read() path is used.
    Also stop reads past the end of a file after a seek. That read used to
    fail in flash_area_read(), but faults when done through XIP.
2026-10-29 Release XIP references when erasing the image partition
    zsw_filesytem_erase() cleared the open file slots without dropping their
    XIP references, which would keep XIP on. Close open files first, which also
    makes the open file count it logs correct.
    Also fix the BLE logging path in the release build docs.
2026-10-29 Fit the XIP reference count in legacy v5 RAM
    The legacy v5 debug build overflowed RAM by 24 bytes, the k_mutex and
    counter added to the XIP manager. Use an atomic counter instead: the QSPI
    driver serializes its own enable/disable, and zsw_xip_try_get() re-enables
    XIP before it returns, so no lock is needed.
    Also lower the open image file slots from 64 to 48. LVGL keeps only a few
    files open at a time, and this frees 320 bytes.
2026-10-29 Let the display flush run while LVGL renders
    LVGL renders on the cooperative system workqueue, so its flush thread
    only got the CPU when rendering blocked. Reads through the XIP mapping
    never block, so the SPI flush waited for rendering to finish and the two
    ran one after the other.
    Make the flush thread a higher priority cooperative thread and yield
    after each flush request, so the SPI transfer starts while the next part
    renders. Scrolling the watchface picker on the Watch DK went from about
    9 to 15-20 FPS.
2026-10-29 Create the watchface right away when it opens
    watchface_app_start() created the watchface 100 ms later from a work
    item, so going back from the app picker first rendered the empty root
    screen, a black frame, and then the watchface.
    The delay is left from when the UI ran on its own work queue. Rendering
    and the UI now share the system workqueue, and callers have already
    deleted the previous screen, so create the watchface directly.
2026-10-29 Show the current watchface gestures in the controls help
    Swipe right now opens Tiles when that app is enabled, and a long press
    opens the watchface picker. Update the Settings controls page and the
    onboarding gestures page, and size the onboarding list to its text so
    "Swipe down: Quick panel" is no longer cut off.
2026-10-30 Run the calculator state machine in the button callback
    The calculator had its own thread with a 1 KB stack that was always
    allocated, and it called into the UI from that thread through a work
    item. Run the state machine directly in the LVGL click callback
    instead, and reset it each time the app opens so the display and the
    state match.
2026-10-30 Hold a whole MCUmgr request in the UART line buffers
    uart_mcumgr passes each 128-byte line to the system workqueue, which
    also renders LVGL and handles BLE. With only two line buffers, lines
    that arrive while a frame renders are dropped and the request times
    out. smpclient 7.2 and later send requests up to the 2475-byte netbuf,
    about 27 lines in one burst, so USB updates from it never got past
    the first chunk. Use 28 buffers (about 3.3 KB of RAM). Full image
    uploads now run at about 57 KB/s.
2026-10-30 pytest: test the HTTP relay over NUS
    Plays the phone for the Weather app: answers its GPS request, replies to
    the HTTP request with an error, then answers the retry with an
    Open-Meteo shaped body and checks that the watch parses it.
2026-10-31 Add an lv_heap shell command
    Prints LVGL heap use and the peak since boot when heap runtime stats are
    enabled, for sizing CONFIG_LV_Z_MEM_POOL_SIZE.
2026-10-31 Stop dropping voice memo audio while the UI is busy
    Recording while launching apps overflowed the 2 KB PCM ring buffer:
    LVGL renders in the cooperative sysworkq and Opus needs about 4 ms per
    10 ms frame, so the codec falls behind for a while. Use an 8 KB ring
    buffer (heap, only while recording), yield to the microphone thread
    between frames and check free space once a second instead of for every
    1 ms block. Document why the microphone slab stays at 300 blocks.
2026-10-31 Allocate the voice memo codec stack from the heap
    The 12 KB Opus thread stack is only used while recording. The system heap
    peaks at 46 KB of 60 KB during a recording and is mostly empty otherwise,
    so take the stack from it at start and free it at stop. Saves 12 KB of
    static RAM.
2026-10-31 Drop ble_fota from pytest and docs now that SMP is always on
    The tests no longer enable SMP before using it, and the shell checks
    use power status instead. The firmware update page no longer asks to
    turn on BLE for nRF Device Manager.
2026-10-31 Remove Sensors Summary Application and related configurations
2026-11-02 Keep the CPU at 128 MHz while recording a voice memo
    With the screen off the CPU runs at 64 MHz, where Opus takes about 7.5 ms
    of every 10 ms frame. Any extra load, like BLE SMP traffic, then makes
    the cooperative codec fall behind and starve other threads. Add a
    reference-counted fast hold to zsw_cpu_freq that zsw_cpu_set_freq()
    respects, and take it for the length of a recording.
2026-11-02 Save voice memos in the background after stop
    Stop rewrote the header at offset 0 and synced in the caller's thread,
    usually LVGL. LittleFS copies the whole file for that, about 3.3 s for a
    40 s recording, so the UI froze and repeated taps on stop were queued.
    Stop now only stops the microphone and returns; the codec thread saves
    the file and publishes STOPPED. Start returns -EBUSY until then, the
    list and delete skip the file being written, and the Memos app shows
    Saving... and ignores record taps for 2 s after the list returns,
    because the record button is where the stop button was.
2026-11-02 pytest: remove the HTTP relay over NUS test
    It hard-codes the Weather app's requests and Open-Meteo response format.
    This reverts commit 503344a94cae53ab37ca91312a5809dc56fd6006.
2026-11-02 Replace the CPU frequency API with request/release
    zsw_cpu_set_freq() and the hold functions were two ways to set the same
    clock. Keep one refcounted pair, like XIP: the clock is 128 MHz while
    anyone holds a request. The power manager holds one while active.
2026-11-02 refactor: bmp581: Enhance BMP581 driver with configuration and sample handling improvements
2026-11-02 refactor: Update floor counter and pressure sensor logic for improved daily reset handling and logging
2026-11-02 docs: update architecture docs with new drivers changes.
2026-11-03 Keep the display on when the arm is raised after waking
    The tilt-away check saves the orientation at wake-up as the "facing the
    user" reference. When the watch woke with the arm hanging down, for
    example on a notification, raising the arm to look moved it far from that
    reference and the display turned off right away.
    If the watch leaves the reference and settles in a pose where the display
    faces up clearly more than before, take that pose as the new reference
    instead of treating it as tilted away. Lowering the arm from there still
    turns the display off quickly. The reference is also learned only once
    the orientation has settled, not from samples taken mid-motion.
2026-11-03 pytest: keep existing bond on devices without USB
2026-11-04 refactor: enhance pressure sensor handling with fast sampling support
2026-11-06 Refactor: remove priodic prints and add status print in state transitions.
